ofenerci/light8080/doc/Light8080 Core Specifications.odt

Light8080 CPU

Core Specifications

Written for publication on:

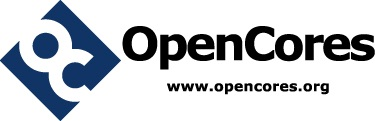
[picture p1: figure]

File name: Light8080 Core Specifications

Version: 0.2

Creation Date: 03/12/12

Update Date: 05/26/12

Authors: José A. Ruiz

Moti Litochevski

Index of Tables

Table 1: Core Synthesis Results, VHDL version 6

Table 2: Core Synthesis Results, Verilog version 6

Table 3: CPU core interface description 7

Index of Figures

Figure 1: Memory Read Cycle 8

Figure 2: Memory Write Cycle 9

Figure 3: I/O Read Cycle 10

Figure 4: I/O Write Cycle 10

Figure 5: EXER8080 execution output 15

1. Preface

## Scope

This document describes the Light8080 CPU IP core operation, architecture and interfaces.

## Revision History

Rev | Date | Author | Description
0.1 | 03/12/12 | José A. Ruiz | First Draft
0.2 | 05/26/12 | José A. Ruiz | Added compatibility information, fixed errors.

## Abbreviations

CP/M | Operating System most often used with the i8080, very popular in the 70's and 80's. Plenty of information available online (http://en.wikipedia.org/wiki/CP/M).

2. Introduction

The present document describes the interface of the Light8080 CPU core and gives brief usage instructions. Together with the demos and test benches provided with the project, the information provided in this document should be enough to use the core.

The OpenCores page for this project can be found here:

OpenCores project: Lightweight 8080 compatible CPU :: OpenCores (http://opencores.org/project,light8080)

This document will not cover anything that is already covered in the 8080 datasheets and manuals; namely, the opcode behavior, reset values for internal flags, etc. Except for some details explained in section 5, the core is fully compatible with the original 8080 and thus original programming reference material can be used.

The project includes a 'design notes' document that explains briefly the architecture of the core and the format and behavior of the microcode. None of that information is necessary to use the core in an application so it has been omitted from this document.

This core was originally a VHDL-only project. Thanks to Moti Litochevski's efforts the core is now supplied in a Verilog version too. Two source branches can be found in the project directory tree for the Verilog and VHDL cores and supporting modules.The Verilog core is meant to be identical to the VHDL core – that is, it's the same circuit under a different formulation. This document applies to both versions of the core unless otherwise noted.

This core has been designed to minimize area while supporting a decent clock rate. In order to reach that goal, the micromachine has been extremely simplified, with the result that instruction execution takes many more clock cycles than in the original 8080 – instruction execution times are compared in section 6. Overall, the core is about 40% slower than an i8080 at the same clock rate.

### Synthesis results

The following tables summarize the synthesis results of the bare CPU core (excluding any peripherals, program ROM or interrupt controller). The bare CPU is hardly useable without some support modules but the numbers given below should be a useful guide in estimating the size of a complete SOC core.

The VHDL version of the CPU includes only file light8080.vhdl. Synthesis results are given below.

Manufacturer | Family | Grade | Optimization | Elements Utilization | Fmax
Xilinx | Spartan 3 | -5 | Speed | 209 LUTs + 1 BRAM | > 100 MHz
Xilinx | Spartan 2 | -5 | Speed | 203 LUTs + 4 BRAMs | > 60 MHz
Altera | Cyclone II | C7 | Balanced | 413 LCs + 4 M4Ks | > 85 MHz

Table 1: Core Synthesis Results, VHDL version

The Verilog version of the CPU comprises two files, light8080.v and micro_rom.v. Synthesis results are given below and are nearly identical to the VHDL version, as would be expected from a RTL straight port.

Manufacturer | Family | Grade | Optimization | Elements Utilization | Fmax
Xilinx | Spartan 3 | -5 | Speed | 209 LUTs + 1 BRAM | > 100MHz
Xilinx | Spartan 2 | -5 | Speed | 203 LUTs + 4 BRAMs | > 60 MHz
Altera | Cyclone II | C7 | Balanced | 404 LCs + 4 M4Ks | > 80 MHz

Table 2: Core Synthesis Results, Verilog version

The above results where obtained using the following software versions:

- Xilinx ISE 9.2i (App. Version J.36)
- Altera Quartus II 9.0 build 235 SP 2
3. CPU core Interface

The following table summarizes the CPU core interface ports.

Name | Direction | Width | Description
clk | input | 1 | Global clock, active rising edge.
reset | input | 1 | Global core synchronous reset, active high.
addr_out | input | 16 | Address bus.
data_in | input | 8 | Input data bus.
data_out | output | 8 | Output data bus.
vma | output | 1 | Valid Memory Address, active when addr_out is valid.
io | output | 1 | Active high when access is I/O as opposed to memory.
rd | output | 1 | Active high for read cycles.
wr | output | 1 | Active high for write cycles.
fetch | output | 1 | Active high for read cycles
inta | output | 1 | Active high in interrupt acknowledge cycles.
inte | output | 1 | Active high when interrupts are enabled.
halt | output | 1 | Active high when the CPU is halted.
intr | input | 1 | Interrupt request input.

Table 3: CPU core interface description

  All input signals are assumed to be synchronous to the master clock.
  Since all these signals are meant to be internal to the FPGA, no effort has been made to characterize the setup and hold times for the inputs; and no synchronization logic is used at any of the inputs. The user should take care of this if any of the CPU inputs are to be driven from ouside the chip.

## Memory and I/O interface

The memory interface is meant for connection to internal, synchronous BRAM.

Signal vma works as the synchronous master memory and io. More specifically:

- All memory/io control signals (io,rd,wr) are valid only when vma is high. They never activate when vma is inactive.
- Signals data_out and addr_out are only valid when vma='1'. The high address byte is 0x00 for all io accesses.
- Signal data_in should be valid by the end of the cycle after vma='1', data is clocked in by the rising clock edge.

### Memory cycles

  These are the chronograms for the memory read and write cycles.
  Figure 1: Memory Read Cycle clk addr_out data_in vma rd wr io data_out address rd data
  Figure 2: Memory Write Cycle clk addr_out data_in vma rd wr io data_out address wr data

In the present version of the core there is no provision for wait states.

### Opcode fetch cycles

An opcode fetch cycle is identical to a regular memory read cycle except signal fetch is asserted at the same time as signal vma.

When fetching multibyte instructions, signal fetch is asserted for the opcode fetch cycle only (the first cycle). Remember that the 8080 does not have any opcode longer than one byte, all extra bytes in multibyte instructions are operands.

### I/O Cycles

  I/O cycles are identical to memory cycles except for the assertion of signal io.
  Figure 3: I/O Read Cycle clk addr_out data_in vma rd wr io data_out address rd data
  Figure 4: I/O Write Cycle clk addr_out data_in vma rd wr io data_out address wr data
  Like in the original 8080, the 8 most significant bits of the address bus in any I/O cycle are zero and the I/O port address is output in the lowest 8 bits.

## Interrupts

  The interrupt interface follows the behaviour of the original, with the exceptions mentioned below.
  Signal inte reflects the state of the internal interrupt enable flag. Interrupts can be enabled or disabled under software control (instructions EI and DI), and are automatically disabled when an interrupt is acknowledged, as in the original 8080. Interrupts are enabled when inte is high.
  Signal intr is sampled on all positive clock edges. If asserted when inte is high, interrupts will be disabled, inta will be asserted high and a fetch cycle will occur immediately after the current instruction ends execution, except if intr was asserted at the last cycle of an instruction. In that case it will be honored after the next instruction ends.
  The special instruction fetch cycle that occurs when inta is high is called an interrupt acknowledge cycle.
  The instruction fetched on the interrupt acknowledge cycle will be executed normally, except that PC will not be valid in any subsequent fetch cycles of the same instruction after the first (in multibyte instructions), and will not be autoincremented (In practice, the same as the original 8080).
  Inta will remain high for the duration of the fetched instruction, including fetch and execution time (in the original 8080 it was asserted only for the opcode fetch cycle).
  PC will not be autoincremented while inta is high, but it can be explicitly modified (that is, instructions like RST or CALL can be executed). Again, the same as the original.
  Interrupts will be disabled upon assertion of inta, and remain disabled until explicitly enabled again by the program, usually with an EI instruction immedialely before the interrupt routine RET instruction (as in the original). Remember that EI does not enable interrupts until after the next instruction, as can be seen in the 8080 manual.
  If intr is asserted when inte is low, the interrupt will not be attended but it will be registered in an internal int_pending flag, so it will be honored when interrupts are reenabled. The internal pending interrupt flag can't be cleared except by reset.  The above implies that any instruction can be supplied in an inta cycle, either single byte or multibyte. The original 8080 was subject to some limitations that don't apply to this core.
  Like in the original 8080, the CPU relies on external logic to supply an interrupt vector (an instruction) at the interrupt acknowledge special fetch cycle. This instruction would usually be a single-byte RST but in principle it can be any instruction.
  Supplying a multibyte instruction as an interrupt vector is somewhat difficult because the core does not provide any way to tell the second fetch cycle or the third – only the first is marked by the assertion of signal fetch. The external interrupt control logic must provide for this defficiency, which the original 8080 shares. Therefore the user is advised to use RST instructions as interrupt vectors.

## Reset

  Signal reset is synchronous and needs to be active for just 1 clock cycle. Once reset is deasserted, the first fetch at address 0x0000 will happen 4 cycles later.
4. Compatibility to original 8080

This core is 100% compatible to the original Intel silicon, in both its documented and undocumented behavior, except for one of the following special instructions:

Instructions not 100% compatible to undocumented Intel 8080 behavior
DAA | CMA | STC | CMC

At least one of the above instructions is not compatible to Intel 8080 undocumented behavior.

It's important to note that the documented behavior is 100% compatible to the original.

The following section explains what means have been used to assess compatibility.

### Opcode exerciser

In order to test the core compatibility, a freely available 8080 instruction exerciser called 8080EXER has been used (http://www.idb.me.uk/sunhillow/8080.html).

The code exerciser is a very lengthy program which takes long to execute in a real 8080. It is just not practical to run it in a simulated environment – its logic is quite convoluted and a simulation log would not be helpful as a diagnostics tool anyway.

Therefore, the exerciser has been run only on real hardware. A demo is included in the project tree which targets Digilentic's DE-1 development board (directory sw/demos/exer). As usual, the demo can be ported to other boards easily.

8080EXER runs all the 8080 opcodes with a large number of parameter combinations. The program computes a CRC value for the CPU state after testing each block of CPU opcodes. That CRC value can then be compared against the value produced by running the program on a baseline 8080 – namely, Intel's original.

If the CRCs match, it can be safely assumed that the behavior of the CPUs is identical.

You will find a more detailed explanation in the program's web site.

8080EXER is a CP/M program. In order to run it on a bare metal CPU I have had to make the following modifications:

- Added code that emulates a few CP/M BDOS functions needed to output text.
- Adapted the code to work on the C2SB demo board within the l80soc module.
- Added the original Intel CRC values for comparison.
- Halted the program after the tests are done instead of returning to the (unexistent) CCP.

The source code is in a format compatible to CP/M M80 assembler and incompatible to TASM, AS80 and all other Windows and linux 8080 assemblers that I know of. So it has to be compiled from within a CP/M machine. I used the simh simulator (http://simh.trailing-edge.com), which comes with a suite of CP/M tools including the assembler and linker.

The demo includes a CP/M 'batch' script called 'MAC.SUB'. This script can be used to assemble the source with this invocation:

DO MAC 8080EXER

I hope this saves you the trouble to find and read M80 documentation, but this is as far as I can guide you through CP/M. Simh includes excellent documentation and there's plenty of CP/M documentation available.

At any rate, you don't need to assemble EXER8080 yourself unless you need to modify it. I have included the assembled object code as an HEX file. All you hae to do is run the included 'build.bat' script. Or even better, use the pre-built obj_code_pkg.vhdl file included in the demo.

The readme.txt file incuded in the demo directory gives synthesis instructions.

### Opcode exerciser execution results

The tests take about 11 minutes to execute on a 50MHz core.

As you can see in Figure 5 below, all the opcodes match the original behavior with the exception of the 'special opcode' group which includes DAA, CMA, STS and CMC.

Of these four opcodes, all but DAA are very simple instructions that can hardly have any undocumented behavior.

DAA, on the other hand, is very poorly documented. Legend has it that even the NEC engineers that second-sourced the i8080 back in the day failed to get it righ – and yet the NEC 8080s could run CP/M, for example.

Here's the execution output:

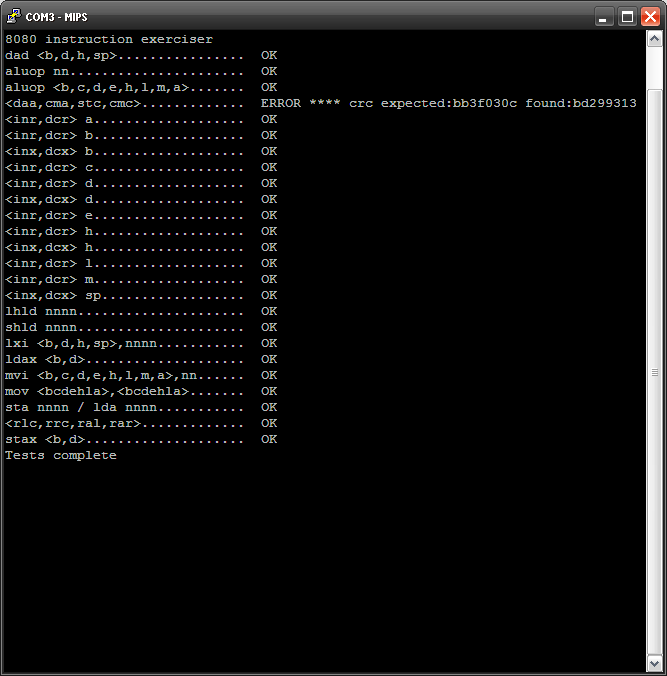
[picture p2: figure]

Figure 5: EXER8080 execution output

Given these results, the core can be considered almost ready for actual use (that is, if an 8080 core can have any actual use). It will be deemed totally ready when all opcodes match the original.

On a side note, the demo takes some 11 minutes to run on a 50MHz core, and about 200 minutes on a 2MHz i8080 according to EXER8080 web site. Therefore, for this particular code sample a 50MHz core runs about as fast as a 36MHz i8080 would. Detailed opcode clock cycle counts can be found in the following section.

5. Instruction timing

The light8080 core is substantially slower than the original 8080 in clock cycles, as a consequence of the strong emphasis placed in area reduction. The following table gives execution times for all instructions in both the original CPU and this core.

Instruction | Intel 8080 | Light8080 | | Instruction | Intel 8080 | Light8080
MOV r1, r2 | 5 | 6 | | XRA r | 4 | 6
MOV r, M | 7 | 9 | | XRA M | 7 | 9
MOV M, r | 7 | 9 | | XRI data | 7 | 9
MVI r, data | 7 | 9 | | ORA r | 4 | 6
MVI M, data | 10 | 12 | | ORA M | 7 | 9
LXI rp, data16 | 10 | 14 | | ORI data | 7 | 9
LDA addr | 13 | 16 | | CMP r | 4 | 6
STA addr | 13 | 16 | | CMP M | 7 | 9
LHLD addr | 16 | 19 | | CPI data | 7 | 9
SHLD addr | 16 | 19 | | RLC | 4 | 5
LDAX rp | 7 | 9 | | RRC | 4 | 5
STAX rp | 7 | 9 | | RAL | 4 | 5
XCHG | 4 | 16 | | RAR | 4 | 5
ADD r | 4 | 6 | | CMA | 4 | 5
ADD M | 7 | 9 | | CMC | 4 | 5
ADI data | 7 | 9 | | STC | 4 | 5
ADC r | 4 | 6 | | JMP | 10 | 15
ADC M | 7 | 9 | | Jcc | 10 | 12/16
ACI data | 7 | 9 | | CALL | 17 | 29
SUB r | 4 | 6 | | Ccc | 11/17 | 12/30
SUB M | 7 | 9 | | RET | 10 | 14
SUI data | 7 | 9 | | Rcc | 5/11 | 5/15
SBB r | 4 | 6 | | RST n | 11 | 20
SBB M | 7 | 9 | | PCHL | 5 | 8
SBI data | 7 | 9 | | PUSH rp | 11 | 19
INR r | 5 | 6 | | PUSH PSW | 11 | 19
INR M | 10 | 13 | | POP rp | 10 | 14
INX rp | 5 | 6 | | POP PSW | 10 | 14
DCR r | 5 | 6 | | XTHL | 18 | 32
DCR M | 10 | 14 | | SPHL | 5 | 8
DCX rp | 5 | 6 | | EI | 4 | 5
DAD rp | 10 | 8 | | DI | 4 | 5
DAA | 4 | 6 | | IN port | 10 | 14
ANA r | 4 | 6 | | OUT port | 10 | 14
ANA M | 7 | 9 | | HLT | 7 | 5
ANI data | 7 | 9 | | NOP | 4 | 5

The EXER8080 execution results quoted in the previous section can be used to compare the core versus the original 8080 for a lengthy though perhaps not representative code sample. Those results show that the core is about 40% slower overall than an i8080 at the same clock rate.This, of course, is not important since cycle-count compatibility was not required in this design.

Light8080 Core Specifications Page 17 of 17
