ofenerci/light8080/verilog/rtl/micro_rom.v

//---------------------------------------------------------------------------------------
// 
// Project:			light8080 
//
// Filename:		micro_rom.v 		(November 25, 2011) 
// 
//---------------------------------------------------------------------------------------

module micro_rom 
(
	clock, 
	uc_addr, 
	uc_dout 
); 
//---------------------------------------------------------------------------------------
input			clock;		// global clock 
input	[8:0] 	uc_addr;	// micro code ROM address 
output	[31:0]	uc_dout;	// micro code ROM data 

//---------------------------------------------------------------------------------------
reg [31:0] uc_dat, uc_dout; 

//---------------------------------------------------------------------------------------
// module implementation 
// microcode ROM : see design notes and microcode source file 
always @ (uc_addr) 
begin 
	case (uc_addr) 
		9'h000:	uc_dat <= 32'b00000000000000000000000000000000;
		9'h001:	uc_dat <= 32'b00000000000001001000000001000100;
		9'h002:	uc_dat <= 32'b00000000000001000000000001000100;
		9'h003:	uc_dat <= 32'b10111101101001001000000001001101;
		9'h004:	uc_dat <= 32'b10110110101001000000000001001101;
		9'h005:	uc_dat <= 32'b00100000000000000000000000000000;
		9'h006:	uc_dat <= 32'b00000000000000000000000000000000;
		9'h007:	uc_dat <= 32'b11100100000000000000000000000000;
		9'h008:	uc_dat <= 32'b00000000101010000000000000000000;
		9'h009:	uc_dat <= 32'b00000100000100000000000001010111;
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
	endcase 
end 
// end of microcode ROM

always @ (posedge clock) 
begin 
	uc_dout <= uc_dat;
end 

endmodule 
//---------------------------------------------------------------------------------------
//---------------------------------------------------------------------------------------
