ofenerci/light8080/(commit log)

2009-03-10 New directory structure.
    [c2sb_demo.csv]
2009-07-19 CPM demo pin assignment file (Altera Quartus II)
    [c2sb_cpm.csv]
2009-07-19 CPM demo on cyclone 2 starter board (work in progress)
2009-07-19 pin assignment for IMSAI demo removed
    [c2sb_demo.csv]
2009-07-19 fixed: int request (intr) can now be wider than 1 cycle
    [light8080.vhdl]
2009-07-19 fixed: IE now enables interrupts after a 1-instruction delay (it was enabling interrupts immediately)
    [light8080.vhdl]
2009-07-19 interrupt test bench adapted to the fix in IE instruction
    [light8080_tb1.vhdl]
2009-07-19 added interrupt for single-stepping cleaned up comments a bit
2010-07-10 BUG FIX: XOR operations wre not clearing CY and ACY
    [light8080.vhdl]
2010-07-10 Altair 4K Basic demo on DE-1 board
    [c2sb_4kbasic.csv]
2010-07-10 removed unfinished CPM demo files
    [c2sb_cpm.csv]
2011-02-04 Fixed nasty typo in pin constraints file (clock input)
    [c2sb_4kbasic.csv]
2012-02-12 BUG FIX: Flags CY and AC were not clear by logic instructions Added new flag to microcode: clr_acy Used new flag to clear AC and CY flags unconditonally Modified microcode for XR*, OR* and AN* to use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
    [light8080.vhdl, light8080_tb0.vhdl, tb0.asm]
2012-02-21 Adding Verilog initial version to the svn. Added the c80 Small-C compiler and AS80 assembler.
    [block.cfg]
2012-03-03 Adding interrupt example code to the Verilog implementation. An interrupt controller was added to the sample SOC module and a sample code was added to the "hello.c" example code.
    [block.cfg]
2012-03-18 Corrected bugs in the Small-C compiler.
    [hello.asm, hello.c, ram_image.v]
2012-03-19 Corrected ihex2vlog tool to enable explicit RAM declaration for Spartan 2.
    [ram_image.v]
2012-03-30 Testbenches for VHDL core moved to sw/tb. Added a mini-demo for the VHDL SoC on the DE-1 dev board. Added a mini-testbench for the VHDL SoC.
    [c2sb_pins.csv]
2012-04-09 Fixed a few mistakes in the last code reorganization. Mostly bad paths but also a broken comment in the UART source...
    [uart.vhdl]
2012-04-10 Fixed a number of errors in the last refactor of the VHDL side of the project: - Path errors in the simulation scripts. - The reset pin in the C2SB mini-test-bench was not being driven. - The main vh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
    All of these errors due to not properly verifying the commit...
    [light8080_tb.vhdl]
2012-04-16 DAA logic fixed and simplified
    [light8080.vhdl]
2012-04-16 Improved usability of SoC (memory size calculation) Added comments to SoC code. Fixed starter kit board simulation test bench, added uart loopback
    [l80pkg.vhdl, l80soc.vhdl]
2012-04-16 VHDL demo code reorganized: moved 4kbasic demo to new directory
    [c2sb_4kbasic.csv]
2012-04-16 4kbasic demo code deleted from old directory
    [c2sb_4kbasic.csv]
2012-04-16 Removed old C2SB files from previous location. Updated simulation script to use new directory for C2SB files.
    [c2sb_pins.csv]
2012-04-16 Added 8080EXER instruction exerciser demo for DE-1 board.
2012-04-29 Changed interrupt controller to use RST instruction instead of CALL as interrupt vector. Some bug fixes to the c80 compiler.
    [intr_ctrl.v]
2015-03-24 Add project for Verilog SOC on Mimas V2 board
